cschethana03-hash/Kryptek/Image/Screenshot 2026-10-02 190328.png

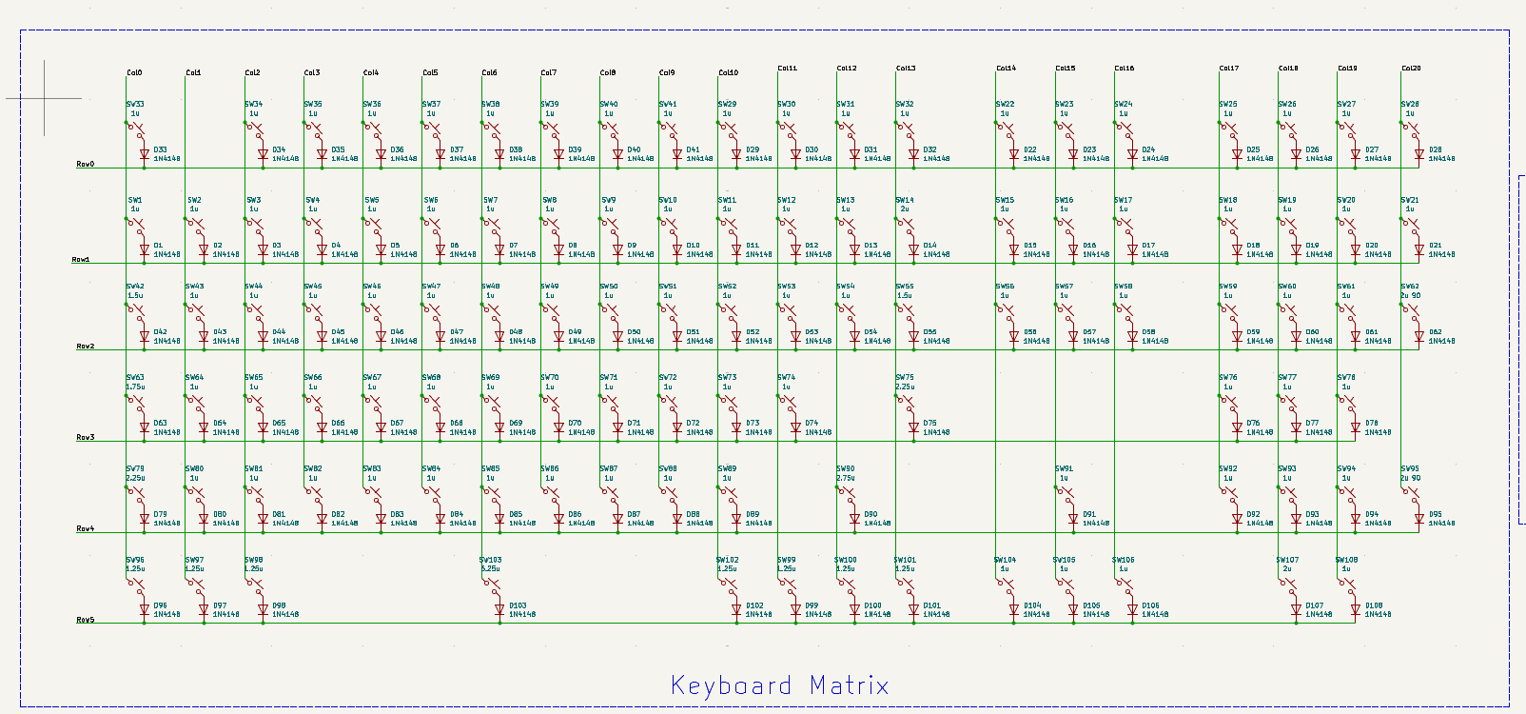
Image/Screenshot 2026-10-02 190328.png
