cschethana03-hash/Kryptek/Image/Screenshot 2026-10-02 190333.png

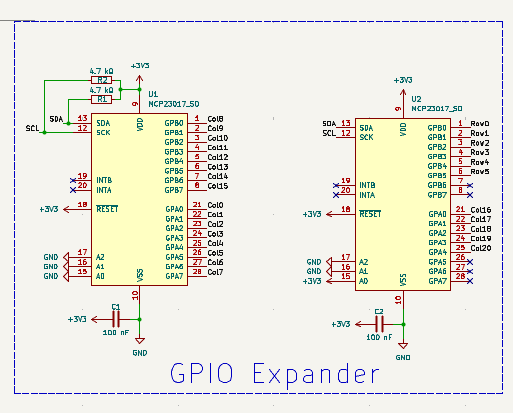
Image/Screenshot 2026-10-02 190333.png
