cschethana03-hash/Kryptek/bom.csv

Name | Purpose | Quantity | Original Total Cost ($) | Original Unit Cost ($) | Distributor | Link
3D printed Case | Keyboard Case | 1 | 8 | 8 | Hack Club | https://printlegion.hackclub.com
PCB fabrication | Keyboard Main Board | 1 | 132.16 | 132.16 | Lioncircuits | https://www.lioncircuits.com/quote
Plum Blossom Cherry Profile Top Shine-Through PBT Keycap Set V2 | Keycaps | 1 | 28.11 | 28.11 | Curiosity Caps | https://curiositycaps.in/products/plum-blossom-cherry-profile-shine-through-dye-sublimation-pbt-keycap-set
Durock Clear Screw-In Stabilizers V2 | Stabilizers | 1 | 24.62 | 24.62 | Stackskb | https://stackskb.com/store/durock-clear-screw-in-stabilizers-v2/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
Akko V3 Penguin Pro Switch (Pack of 45) | Switches | 3 | 49.95 | 16.65 | Stackskb | https://stackskb.com/store/hmx-volume-0-pack-of-35/
Adafruit Feather nRF52840 Express | Microcontroller | 1 | 63.69 | 63.69 | Robu | https://robu.in/product/adafruit-feather-nrf52840-sense/
WLY752530 3.7V 500mAh 1S LiPo Battery | Battery | 1 | 1.71 | 1.71 | Robu | https://robu.in/product/50mah-pcm-protected-micro-li-po-battery/
TCC0805X7R104J500DT-CCTC 100nF 50V 0805 capacitor | Capacitors | 10 | 0.082 | 0.0082 | Robu | https://robu.in/product/100nf-0805-surface-mount-multilayer-ceramic-capacitor-pack-of-40/
CL21B475KPQVPNE Samsung 4.7uF 10V 0805 capacitor | Capacitors | 5 | 0.12 | 0.024 | Robu | https://robu.in/product/cl21b475kpqvpne-samsung-cap-ceramic-4-7uf-10v-x7r-10-pad-smd-0805-125c-t-r-automotive-aec-q200/
1N4148W SOD-123 diode | Diode | 216 | 1.59 | 0.0074 | Robu | https://robu.in/product/1n4148w-sod-123-1206-diodereel-of-3000/
3mm Green DIP LED | LED | 15 | 0.12 | 0.008 | Robu | https://robu.in/product/3mm-green-dip-led-pack-of-50/
3mm Red DIP LED | LED | 15 | 0.14 | 0.0093 | Robu | https://robu.in/product/3mm-red-dip-led-pack-of-50/
TYPE-C-31-M-12 Hroparts 5A 1x16P USB-C connector | USB Type-C | 2 | 0.8 | 0.4 | Robu | https://robu.in/product/type-c-31-m-12-hroparts-5a-1-16p-female-type-c-smd-usb-connectors-rohs/
SM08B-SRSS-TB JST 1x8P right-angle connector | OLED connection | 2 | 1.56 | 0.78 | Robu | https://robu.in/product/sm08b-srss-tblfsn-jst-1x8p-8p-sh-tin-8-25%e2%84%8385%e2%84%83-1a-1-1mm-copper-alloy-surface-mount-smdp1mmsurface-mount%ef%bc%8cright-a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
ERJ6ENF4701V Panasonic 4.7kΩ 0805 resistor | Resistors | 11 | 0.11 | 0.01 | Robu | https://robu.in/product/erj6enf4701v-panasonic-smd-chip-resistor-4-7-kohm-%c2%b1-1-125-mw-0805-2012-metric-thick-film-precision/
CRCW08051K00FKEAHP Vishay 1kΩ 0805 resistor | Resistors | 20 | 0.72 | 0.036 | Robu | https://robu.in/product/crcw08051k00fkeahp-vishay-smd-chip-resistor-1-kohm-%c2%b1-1-500-mw-0805-2012-metric-thick-film-pulse-proof-high-power/
RC0805JR-075K1L Yageo 5.1kΩ 0805 resistor | Resistors | 100 | 0.14 | 0.0014 | Robu | https://robu.in/product/rc0805jr-075k1l-yageo-smd-chip-resistor-5-1-kohm-%c2%b1-5-125-mw-0805-2012-metric-thick-film-general-purpose/
MCP23017-E/SO Microchip I/O expander | GPIO expander | 4 | 8.78 | 2.195 | Robu | https://robu.in/product/mcp23017-e-so-microchip-i-o-expander-16-bit-i2c-serial-1-8-v-5-5-v-soic-28-pins/
USBLC6-2SC6-MS ESD protection | ESD protection | 5 | 0.37 | 0.074 | Robu | https://robu.in/product/usblc6-2sc6-ms-msksemi-4-5a-15v-150w-6v-5v-sot-23-6-esd-and-surge-protection-tvs-esd-rohs/
Waveshare 1.9 inch LCD Display Module | OLED/LCD screen | 1 | 11.17 | 11.17 | Robu | https://robu.in/product/waveshare-lcd-display-module-spi-interface-262k-colors/
Lano Dark Blue Gx16 Aviator Connector Premium Mechanical Keyboard 3.5m Cable | Cable | 1 | 16.64 | 16.64 | Curiosity Caps | https://curiositycaps.in/products/dark-blue-cable-black-connector-cable
TOTAL |  |  | 350.582
