cschethana03-hash/Kryptek/BOM/Screenshot 2026-10-02 194516.png

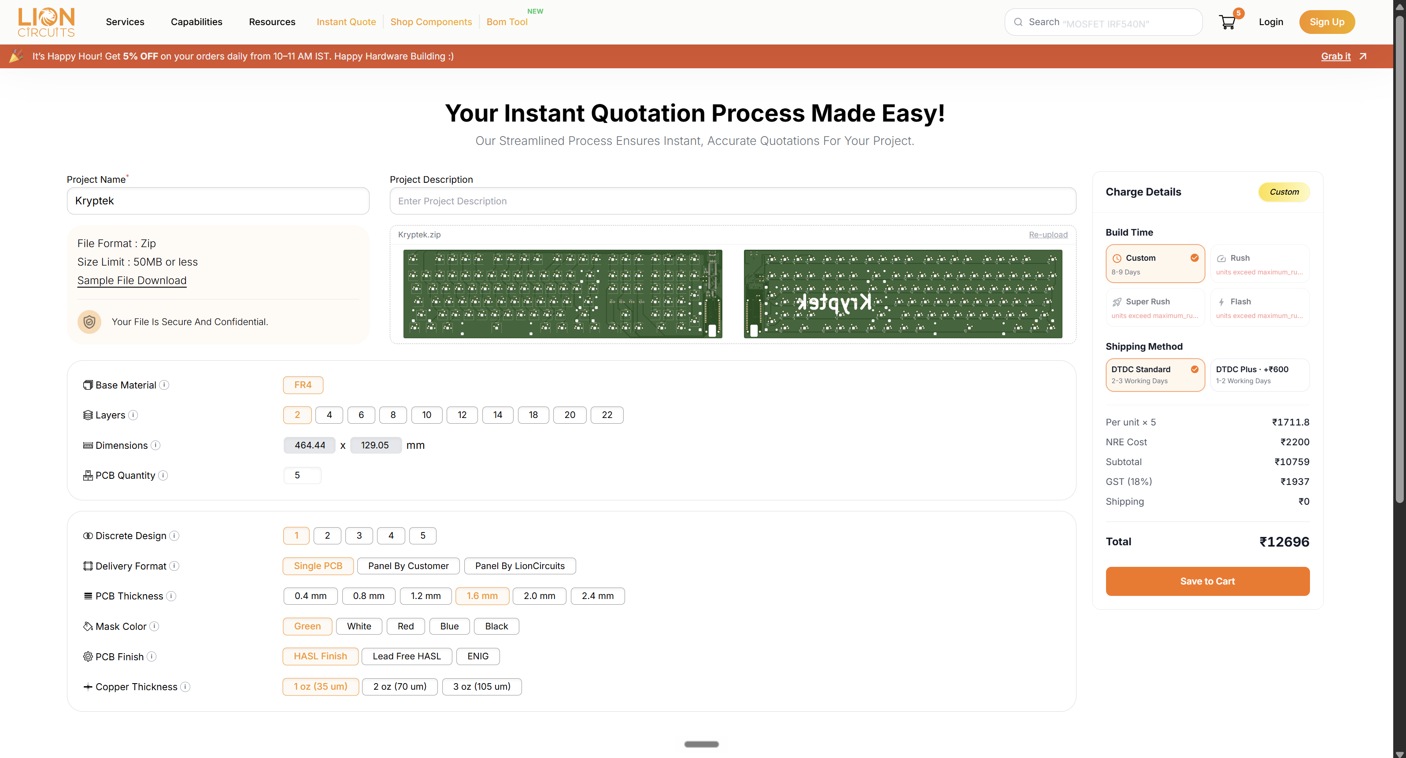
BOM/Screenshot 2026-10-02 194516.png
