cschethana03-hash/Kryptek/BOM/Screenshot 2026-10-02 195901.png

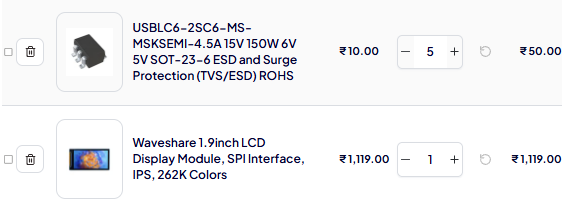
BOM/Screenshot 2026-10-02 195901.png
