cschethana03-hash/Kryptek/CAD/Full/Kryptek.step

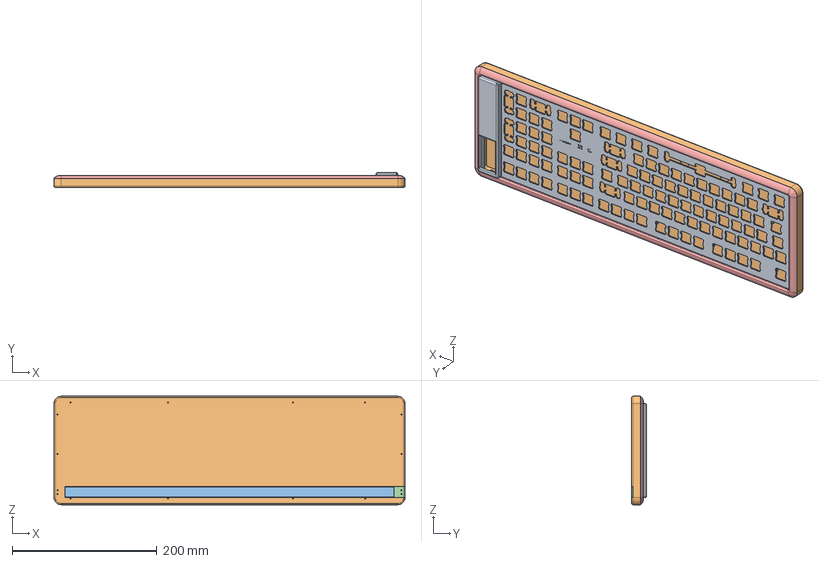
[picture p22: CAD file, 2026-10-03]
CAD/Full/Kryptek.step
485.0 x 20.5 x 150.0 mm
