cschethana03-hash/Kryptek/CAD/Printing/Plate.stl

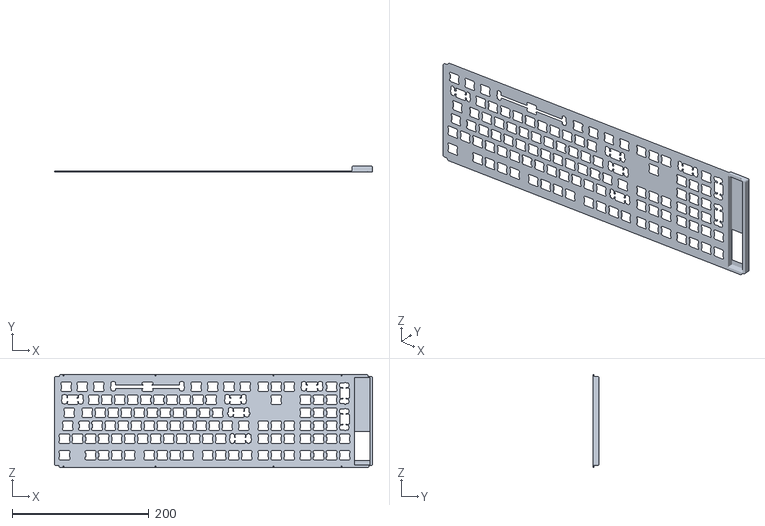
[picture p23: CAD file, 2026-10-03]
CAD/Printing/Plate.stl
465.0 x 9.50 x 136.0
