cschethana03-hash/Kryptek/CAD/Printing/Bottom.stl

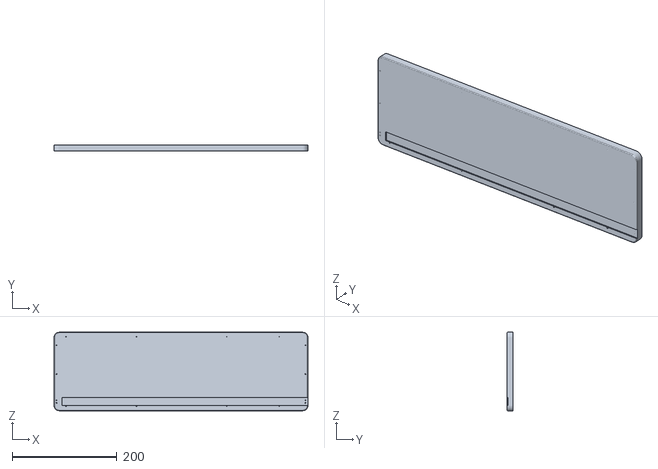
[picture p25: CAD file, 2026-10-03]
CAD/Printing/Bottom.stl
485.0 x 12.4 x 150.0
