cschethana03-hash/Kryptek/CAD/Printing/Bottom Lifter.stl

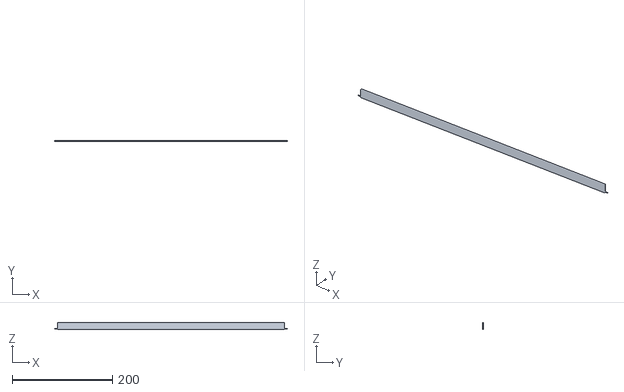
[picture p26: CAD file, 2026-10-03]
CAD/Printing/Bottom Lifter.stl
465.0 x 2.00 x 14.0
