cschethana03-hash/Kryptek/CAD/Printing/Top Plate.stl

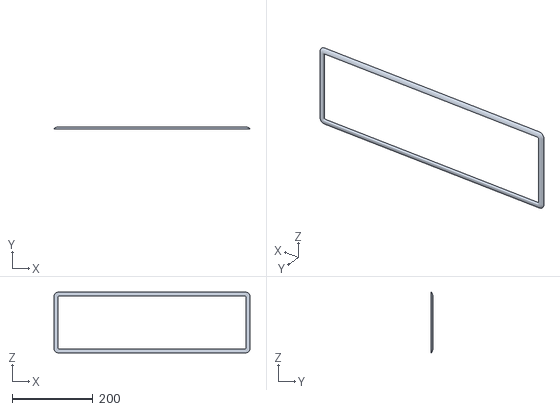
[picture p27: CAD file, 2026-10-03]
CAD/Printing/Top Plate.stl
485.0 x 4.00 x 150.0
