cschethana03-hash/Kryptek/CAD/Printing/Bottom Lifter Screw.stl

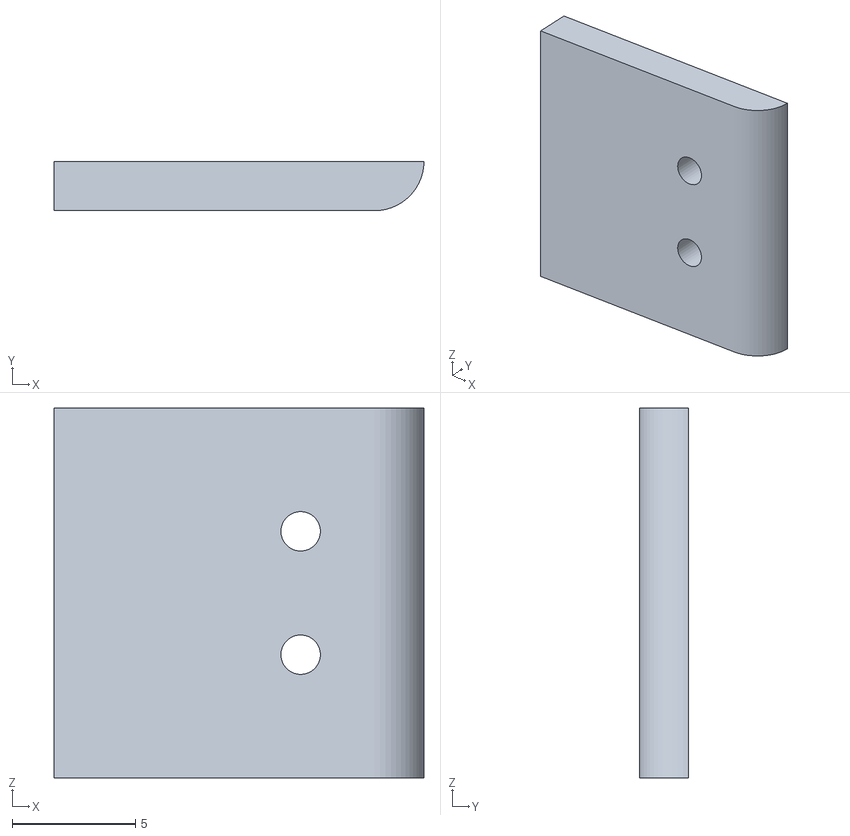
[picture p28: CAD file, 2026-10-03]
CAD/Printing/Bottom Lifter Screw.stl
15.0 x 2.00 x 15.0
