cschethana03-hash/Kryptek/(list of files, cad)

Other CAD files:
Fusion/Kryptek.f3d
