cschethana03-hash/Kryptek/PDF/Kryptek.pdf

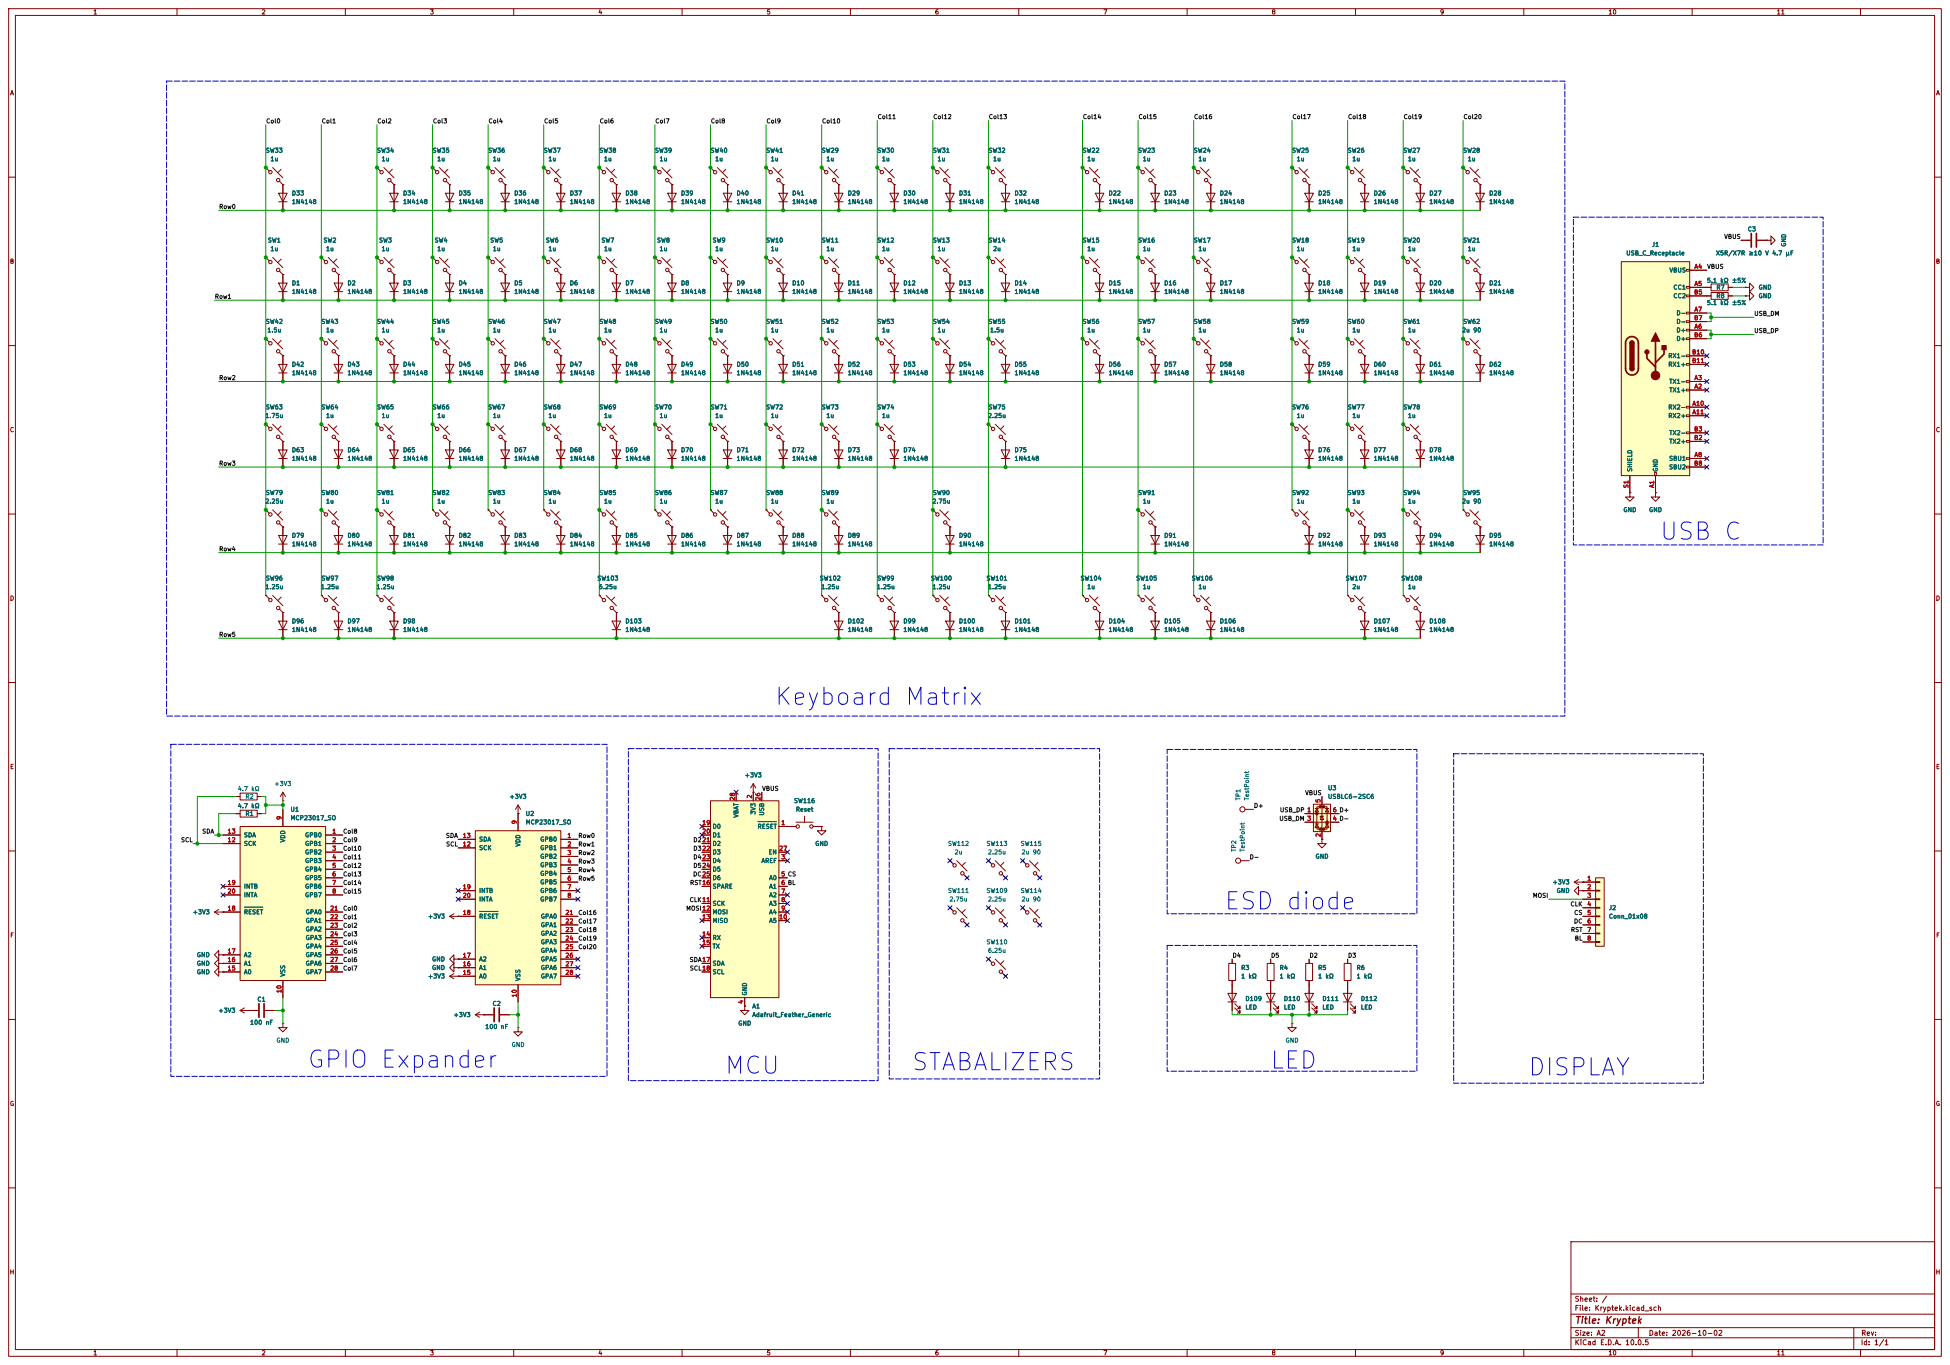
[picture p29: page 1]

SCK 11 MOSI 12 MISO 13 RX 14
CLK

Size: A2 | Rev:
KiCad E.D.A. 10.0.5 | Id: 1/1
