cschethana03-hash/Kryptek/PDF/Kryptek-Layout.pdf

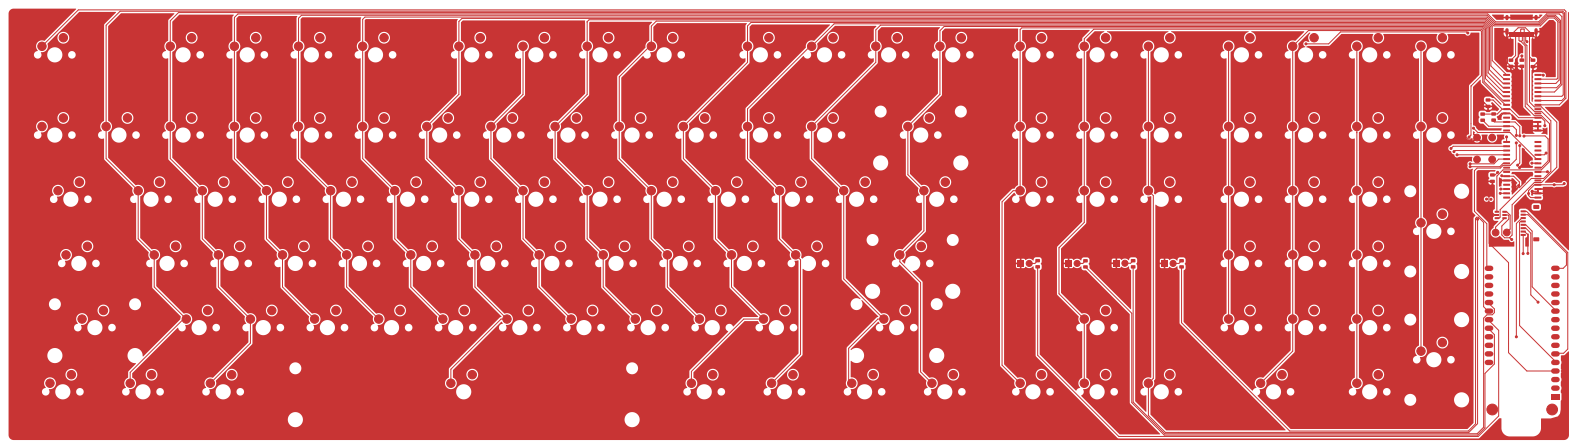
[picture p30: page 1]

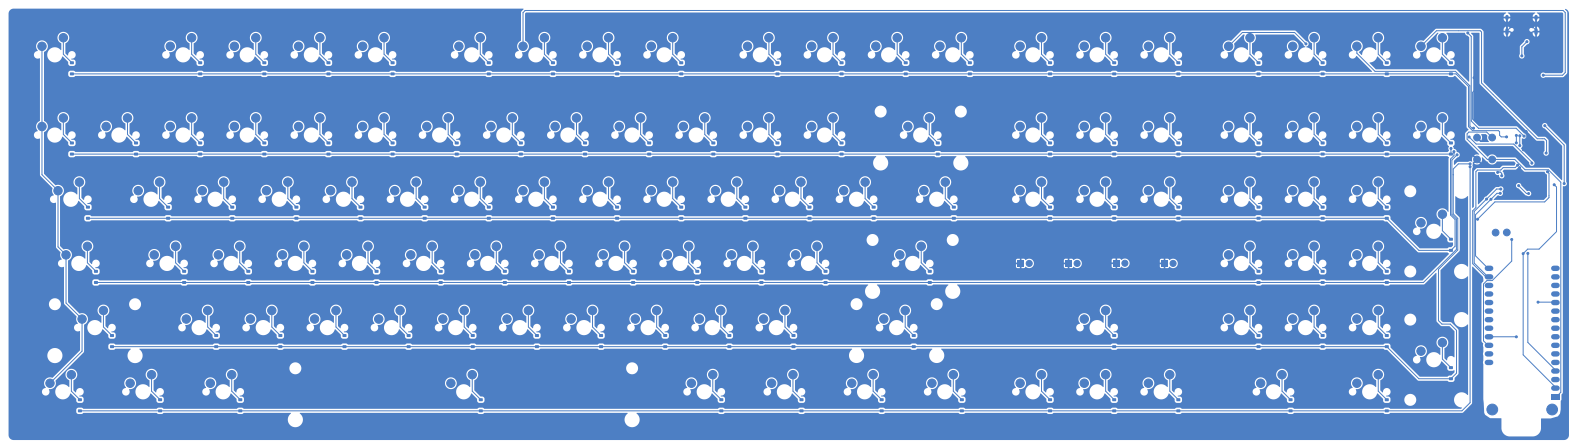
[picture p31: page 2]

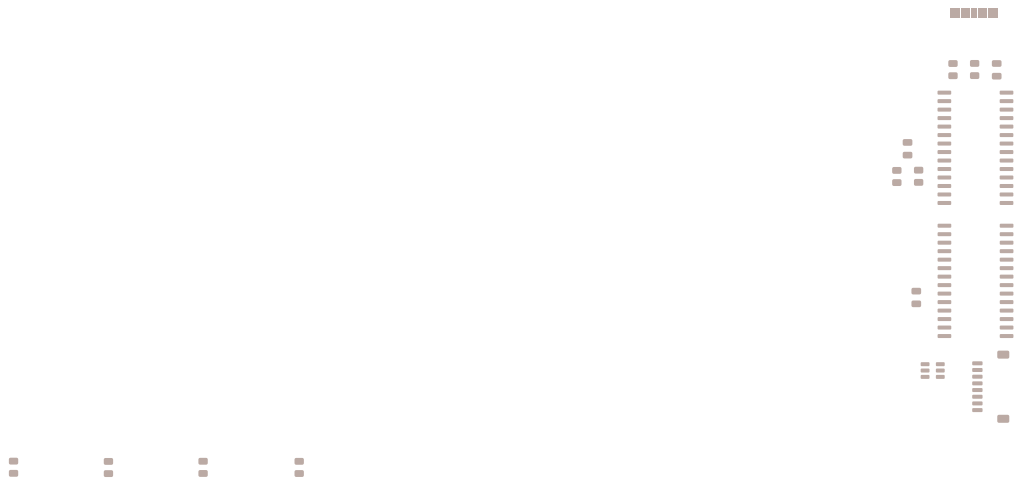
[picture p32: page 3]

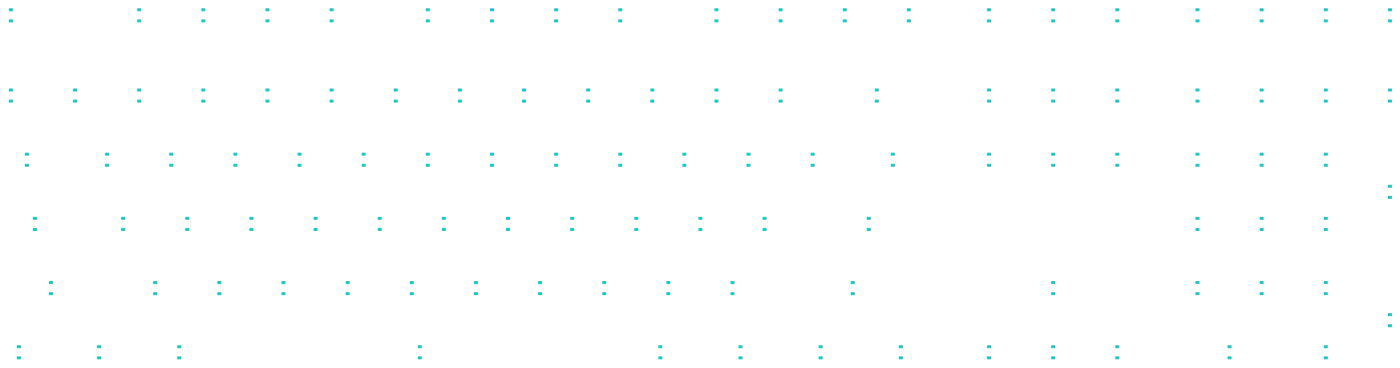
[picture p33: page 4]

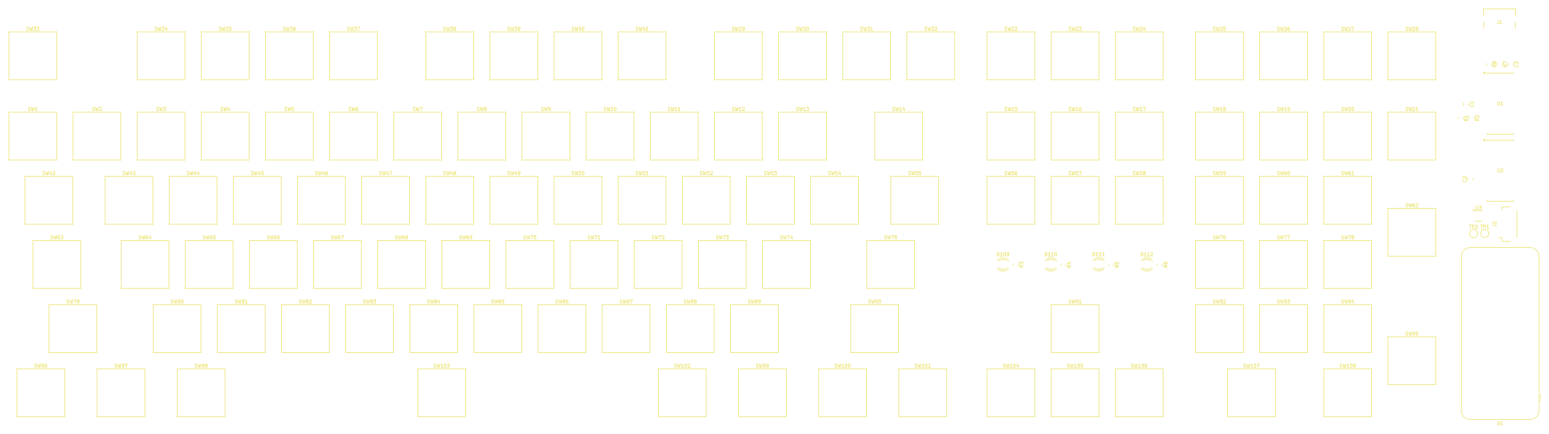
[picture p34: page 5]

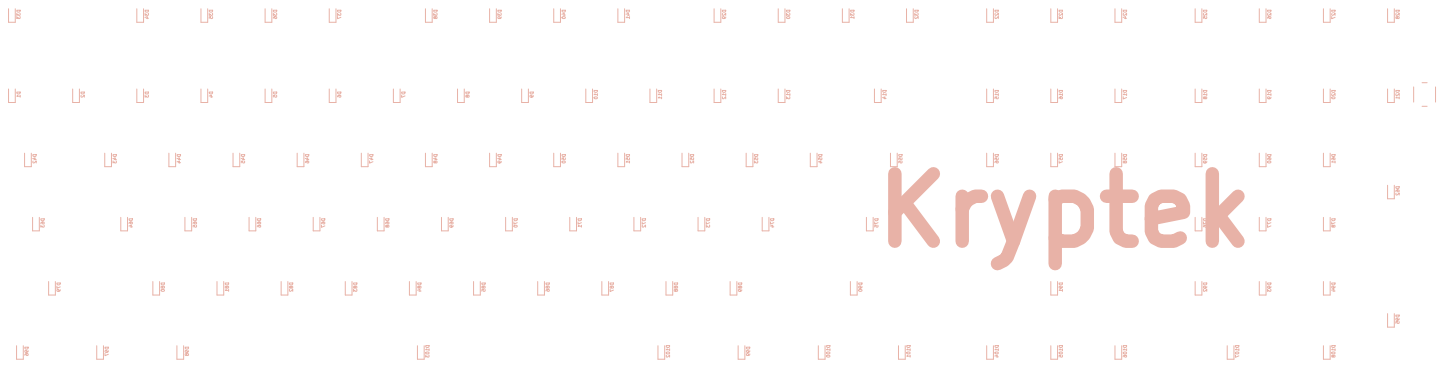
[picture p35: page 6]

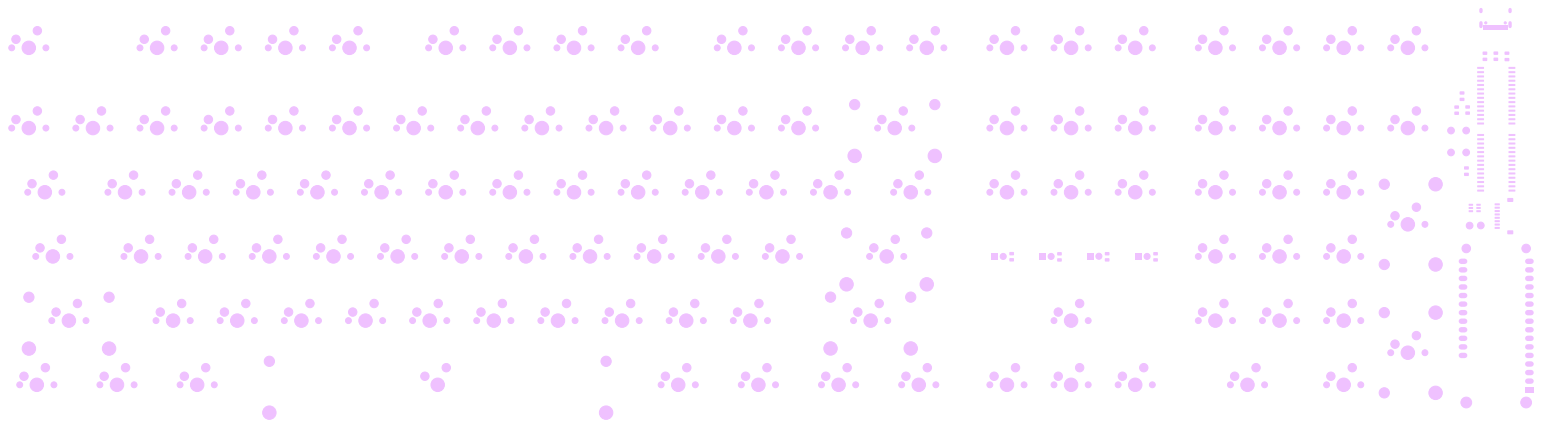
[picture p36: page 7]

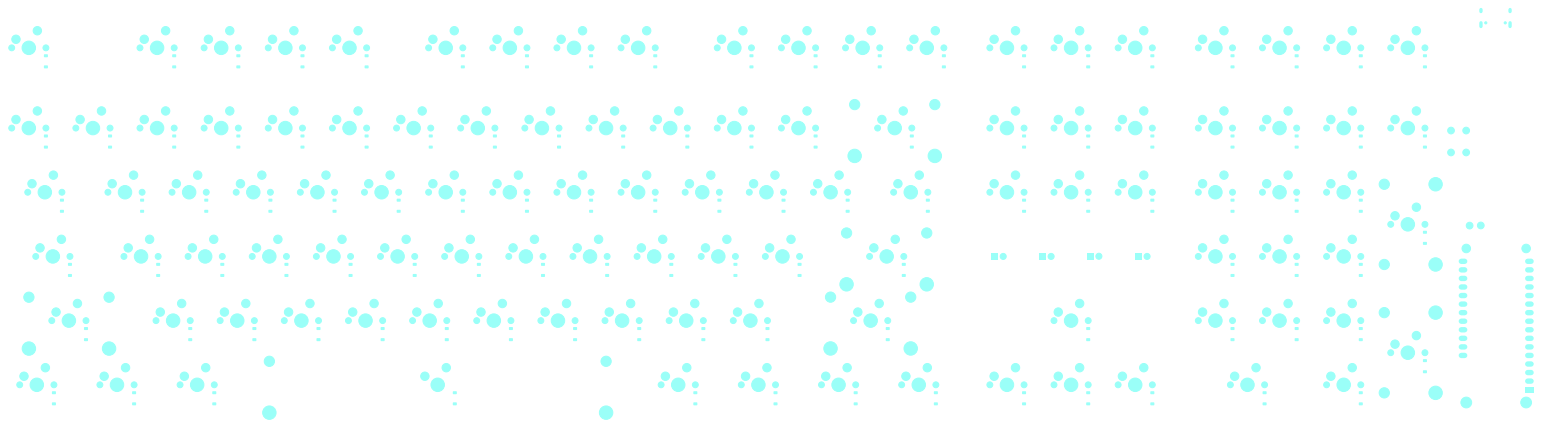
[picture p37: page 8]

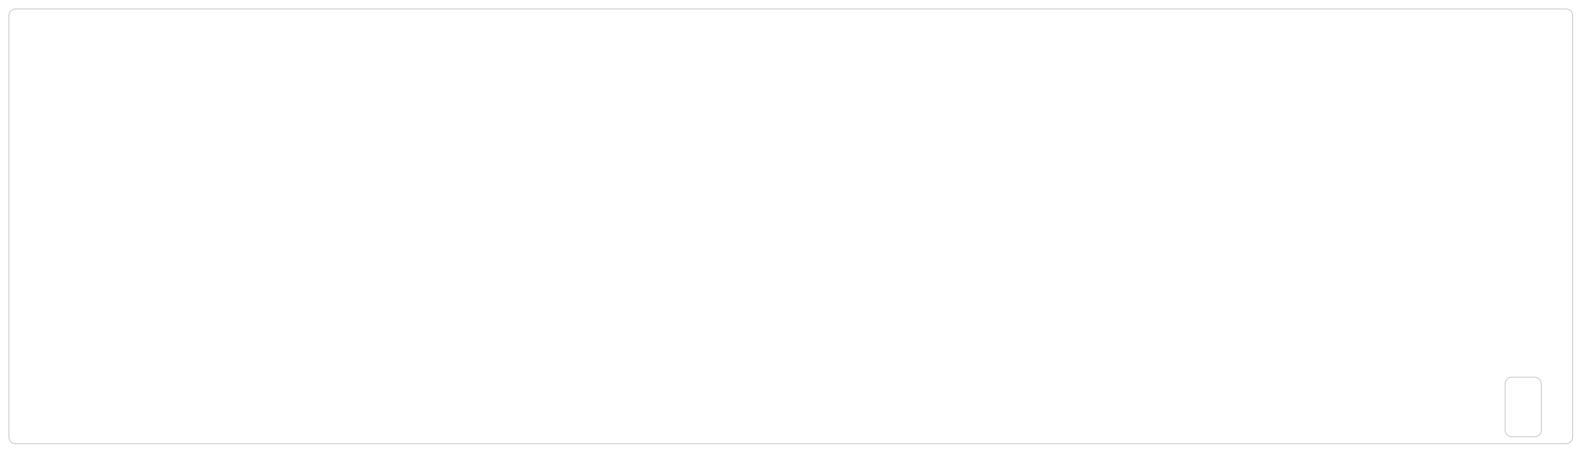
[picture p38: page 9]
